jounih/dc-cv-interface/variants/pico2-4x4/hw/netlist.csv

ref | value | footprint | pin | net
J1 | Eurorack 2x5 shrouded header | IDC 2x5 2.54 mm | 1 | -12V_IN
J1 | Eurorack 2x5 shrouded header | IDC 2x5 2.54 mm | 2 | -12V_IN
J1 | Eurorack 2x5 shrouded header | IDC 2x5 2.54 mm | 3 | GND
J1 | Eurorack 2x5 shrouded header | IDC 2x5 2.54 mm | 4 | GND
J1 | Eurorack 2x5 shrouded header | IDC 2x5 2.54 mm | 5 | GND
J1 | Eurorack 2x5 shrouded header | IDC 2x5 2.54 mm | 6 | GND
J1 | Eurorack 2x5 shrouded header | IDC 2x5 2.54 mm | 7 | GND
J1 | Eurorack 2x5 shrouded header | IDC 2x5 2.54 mm | 8 | GND
J1 | Eurorack 2x5 shrouded header | IDC 2x5 2.54 mm | 9 | +12V_IN
J1 | Eurorack 2x5 shrouded header | IDC 2x5 2.54 mm | 10 | +12V_IN
D1 | SS14 | SMA / DO-214AC | A | +12V_IN
D1 | SS14 | SMA / DO-214AC | K | +12V
D2 | SS14 | SMA / DO-214AC | A | -12V
D2 | SS14 | SMA / DO-214AC | K | -12V_IN
C1 | 10uF 25V | 0805 X5R / radial | 1 | +12V
C1 | 10uF 25V | 0805 X5R / radial | 2 | GND
C2 | 10uF 25V | 0805 X5R / radial | 1 | GND
C2 | 10uF 25V | 0805 X5R / radial | 2 | -12V
U1 | Raspberry Pi Pico 2 (RP2350) | Pico module | 4 | DAC_SCLK
U1 | Raspberry Pi Pico 2 (RP2350) | Pico module | 5 | DAC_SYNC
U1 | Raspberry Pi Pico 2 (RP2350) | Pico module | 6 | DAC_DIN
U1 | Raspberry Pi Pico 2 (RP2350) | Pico module | 14 | ADC_SCLK
U1 | Raspberry Pi Pico 2 (RP2350) | Pico module | 15 | ADC_CS
U1 | Raspberry Pi Pico 2 (RP2350) | Pico module | 16 | ADC_DOUT
U1 | Raspberry Pi Pico 2 (RP2350) | Pico module | 17 | ADC_DRDY
U1 | Raspberry Pi Pico 2 (RP2350) | Pico module | 19 | ADC_DIN
U1 | Raspberry Pi Pico 2 (RP2350) | Pico module | 20 | ADC_RESET
U1 | Raspberry Pi Pico 2 (RP2350) | Pico module | 27 | ADC_CLKIN
U1 | Raspberry Pi Pico 2 (RP2350) | Pico module | 36 | +3V3_D
U1 | Raspberry Pi Pico 2 (RP2350) | Pico module | 40 | VBUS
U1 | Raspberry Pi Pico 2 (RP2350) | Pico module | 3 | GND
U1 | Raspberry Pi Pico 2 (RP2350) | Pico module | 8 | GND
U1 | Raspberry Pi Pico 2 (RP2350) | Pico module | 13 | GND
U1 | Raspberry Pi Pico 2 (RP2350) | Pico module | 18 | GND
U1 | Raspberry Pi Pico 2 (RP2350) | Pico module | 23 | GND
U1 | Raspberry Pi Pico 2 (RP2350) | Pico module | 28 | GND
U1 | Raspberry Pi Pico 2 (RP2350) | Pico module | 33 | GND
U1 | Raspberry Pi Pico 2 (RP2350) | Pico module | 38 | GND
U5 | MCP1700-3302E (LDO 3.3 V) | TO-92 (breadboard) / SOT-23 | IN | VBUS
U5 | MCP1700-3302E (LDO 3.3 V) | TO-92 (breadboard) / SOT-23 | GND | GND
U5 | MCP1700-3302E (LDO 3.3 V) | TO-92 (breadboard) / SOT-23 | OUT | +3V3_A
C3 | 1uF | 0805 | 1 | VBUS
C3 | 1uF | 0805 | 2 | GND
C4 | 1uF | 0805 | 1 | +3V3_A
C4 | 1uF | 0805 | 2 | GND
U2 | DAC8568BIPW | TSSOP-16 | 1 | +3V3_A
U2 | DAC8568BIPW | TSSOP-16 | 2 | DAC_SYNC
U2 | DAC8568BIPW | TSSOP-16 | 3 | +3V3_A
U2 | DAC8568BIPW | TSSOP-16 | 4 | DAC_OUT1
U2 | DAC8568BIPW | TSSOP-16 | 5 | DAC_OUT3
U2 | DAC8568BIPW | TSSOP-16 | 6 | DAC_OUT5
U2 | DAC8568BIPW | TSSOP-16 | 7 | DAC_OUT7
U2 | DAC8568BIPW | TSSOP-16 | 8 | VREF
U2 | DAC8568BIPW | TSSOP-16 | 9 | +3V3_A
U2 | DAC8568BIPW | TSSOP-16 | 10 | DAC_OUT8
U2 | DAC8568BIPW | TSSOP-16 | 11 | DAC_OUT6
U2 | DAC8568BIPW | TSSOP-16 | 12 | DAC_OUT4
U2 | DAC8568BIPW | TSSOP-16 | 13 | DAC_OUT2
U2 | DAC8568BIPW | TSSOP-16 | 14 | GND
U2 | DAC8568BIPW | TSSOP-16 | 15 | DAC_DIN
U2 | DAC8568BIPW | TSSOP-16 | 16 | DAC_SCLK
C5 | 100nF | 0805 | 1 | +3V3_A
C5 | 100nF | 0805 | 2 | GND
C6 | 1uF | 0805 | 1 | +3V3_A
C6 | 1uF | 0805 | 2 | GND
C7 | 150nF C0G/X7R | 0805 | 1 | VREF
C7 | 150nF C0G/X7R | 0805 | 2 | GND
R1 | 10k | 0805 | 1 | DAC_SYNC
R1 | 10k | 0805 | 2 | +3V3_D
R2 | 10k 0.1% | 0805 | 1 | VREF
R2 | 10k 0.1% | 0805 | 2 | VB
R3 | 8.06k 0.1% | 0805 | 1 | VB
R3 | 8.06k 0.1% | 0805 | 2 | GND
C8 | 100pF C0G | 0805 | 1 | VB
C8 | 100pF C0G | 0805 | 2 | GND
U4 | OPA4172ID | SOIC-14 | 4 | +12V
U4 | OPA4172ID | SOIC-14 | 11 | -12V
U4 | OPA4172ID | SOIC-14 | 1 | OPO1
U4 | OPA4172ID | SOIC-14 | 2 | SUM1
U4 | OPA4172ID | SOIC-14 | 3 | VB
U4 | OPA4172ID | SOIC-14 | 7 | OPO2
U4 | OPA4172ID | SOIC-14 | 6 | SUM2
U4 | OPA4172ID | SOIC-14 | 5 | VB
U4 | OPA4172ID | SOIC-14 | 8 | OPO3
U4 | OPA4172ID | SOIC-14 | 9 | SUM3
U4 | OPA4172ID | SOIC-14 | 10 | VB
U4 | OPA4172ID | SOIC-14 | 14 | OPO4
U4 | OPA4172ID | SOIC-14 | 13 | SUM4
U4 | OPA4172ID | SOIC-14 | 12 | VB
C9 | 100nF | 0805 | 1 | +12V
C9 | 100nF | 0805 | 2 | GND
C10 | 100nF | 0805 | 1 | GND
C10 | 100nF | 0805 | 2 | -12V
R11 | 10k 0.1% | 0805 | 1 | DAC_OUT1
R11 | 10k 0.1% | 0805 | 2 | SUM1
RF1 | 82.5k 0.1% | 0805 | 1 | SUM1
RF1 | 82.5k 0.1% | 0805 | 2 | OPO1
CF1 | 47pF C0G | 0805 | 1 | SUM1
CF1 | 47pF C0G | 0805 | 2 | OPO1
DC1 | BAT54S | SOT-23 | 1 | -12V
DC1 | BAT54S | SOT-23 | 2 | +12V
DC1 | BAT54S | SOT-23 | 3 | OPO1
RS1 | 1k 0.66 W anti-surge | 1206 | 1 | OPO1
RS1 | 1k 0.66 W anti-surge | 1206 | 2 | OUT1
JO1 | Thonkiconn PJ398SM | 3.5 mm jack | T | OUT1
JO1 | Thonkiconn PJ398SM | 3.5 mm jack | S | GND
JO1 | Thonkiconn PJ398SM | 3.5 mm jack | TN | NC
R12 | 10k 0.1% | 0805 | 1 | DAC_OUT2
R12 | 10k 0.1% | 0805 | 2 | SUM2
RF2 | 82.5k 0.1% | 0805 | 1 | SUM2
RF2 | 82.5k 0.1% | 0805 | 2 | OPO2
CF2 | 47pF C0G | 0805 | 1 | SUM2
CF2 | 47pF C0G | 0805 | 2 | OPO2
DC2 | BAT54S | SOT-23 | 1 | -12V
DC2 | BAT54S | SOT-23 | 2 | +12V
DC2 | BAT54S | SOT-23 | 3 | OPO2
RS2 | 1k 0.66 W anti-surge | 1206 | 1 | OPO2
RS2 | 1k 0.66 W anti-surge | 1206 | 2 | OUT2
JO2 | Thonkiconn PJ398SM | 3.5 mm jack | T | OUT2
JO2 | Thonkiconn PJ398SM | 3.5 mm jack | S | GND
JO2 | Thonkiconn PJ398SM | 3.5 mm jack | TN | NC
R13 | 10k 0.1% | 0805 | 1 | DAC_OUT3
R13 | 10k 0.1% | 0805 | 2 | SUM3
RF3 | 82.5k 0.1% | 0805 | 1 | SUM3
RF3 | 82.5k 0.1% | 0805 | 2 | OPO3
CF3 | 47pF C0G | 0805 | 1 | SUM3
CF3 | 47pF C0G | 0805 | 2 | OPO3
DC3 | BAT54S | SOT-23 | 1 | -12V
DC3 | BAT54S | SOT-23 | 2 | +12V
DC3 | BAT54S | SOT-23 | 3 | OPO3
RS3 | 1k 0.66 W anti-surge | 1206 | 1 | OPO3
RS3 | 1k 0.66 W anti-surge | 1206 | 2 | OUT3
JO3 | Thonkiconn PJ398SM | 3.5 mm jack | T | OUT3
JO3 | Thonkiconn PJ398SM | 3.5 mm jack | S | GND
JO3 | Thonkiconn PJ398SM | 3.5 mm jack | TN | NC
R14 | 10k 0.1% | 0805 | 1 | DAC_OUT4
R14 | 10k 0.1% | 0805 | 2 | SUM4
RF4 | 82.5k 0.1% | 0805 | 1 | SUM4
RF4 | 82.5k 0.1% | 0805 | 2 | OPO4
CF4 | 47pF C0G | 0805 | 1 | SUM4
CF4 | 47pF C0G | 0805 | 2 | OPO4
DC4 | BAT54S | SOT-23 | 1 | -12V
DC4 | BAT54S | SOT-23 | 2 | +12V
DC4 | BAT54S | SOT-23 | 3 | OPO4
RS4 | 1k 0.66 W anti-surge | 1206 | 1 | OPO4
RS4 | 1k 0.66 W anti-surge | 1206 | 2 | OUT4
JO4 | Thonkiconn PJ398SM | 3.5 mm jack | T | OUT4
JO4 | Thonkiconn PJ398SM | 3.5 mm jack | S | GND
JO4 | Thonkiconn PJ398SM | 3.5 mm jack | TN | NC
U3 | ADS131M04IPW | TSSOP-20 | 1 | +3V3_A
U3 | ADS131M04IPW | TSSOP-20 | 2 | GND
U3 | ADS131M04IPW | TSSOP-20 | 3 | AIN1
U3 | ADS131M04IPW | TSSOP-20 | 4 | GND
U3 | ADS131M04IPW | TSSOP-20 | 5 | GND
U3 | ADS131M04IPW | TSSOP-20 | 6 | AIN2
U3 | ADS131M04IPW | TSSOP-20 | 7 | AIN3
U3 | ADS131M04IPW | TSSOP-20 | 8 | GND
U3 | ADS131M04IPW | TSSOP-20 | 9 | GND
U3 | ADS131M04IPW | TSSOP-20 | 10 | AIN4
U3 | ADS131M04IPW | TSSOP-20 | 11 | ADC_RESET
U3 | ADS131M04IPW | TSSOP-20 | 12 | ADC_CS
U3 | ADS131M04IPW | TSSOP-20 | 13 | ADC_DRDY
U3 | ADS131M04IPW | TSSOP-20 | 14 | ADC_SCLK
U3 | ADS131M04IPW | TSSOP-20 | 15 | ADC_DOUT
U3 | ADS131M04IPW | TSSOP-20 | 16 | ADC_DIN
U3 | ADS131M04IPW | TSSOP-20 | 17 | ADC_CLKIN
U3 | ADS131M04IPW | TSSOP-20 | 18 | ADC_CAP
U3 | ADS131M04IPW | TSSOP-20 | 19 | GND
U3 | ADS131M04IPW | TSSOP-20 | 20 | +3V3_D
C11 | 1uF | 0805 | 1 | +3V3_A
C11 | 1uF | 0805 | 2 | GND
C12 | 1uF | 0805 | 1 | +3V3_D
C12 | 1uF | 0805 | 2 | GND
C13 | 220nF | 0805 | 1 | ADC_CAP
C13 | 220nF | 0805 | 2 | GND
R4 | 10k | 0805 | 1 | ADC_CS
R4 | 10k | 0805 | 2 | +3V3_D
JI1 | Thonkiconn PJ398SM | 3.5 mm jack | T | IN1
JI1 | Thonkiconn PJ398SM | 3.5 mm jack | S | GND
JI1 | Thonkiconn PJ398SM | 3.5 mm jack | TN | GND
RA1 | 49.9k 1% | 0805 | 1 | IN1
RA1 | 49.9k 1% | 0805 | 2 | INM1
RB1 | 49.9k 1% | 0805 | 1 | INM1
RB1 | 49.9k 1% | 0805 | 2 | AIN1
RC1 | 9.09k 1% | 0805 | 1 | AIN1
RC1 | 9.09k 1% | 0805 | 2 | GND
CA1 | 330pF C0G | 0805 | 1 | AIN1
CA1 | 330pF C0G | 0805 | 2 | GND
JI2 | Thonkiconn PJ398SM | 3.5 mm jack | T | IN2
JI2 | Thonkiconn PJ398SM | 3.5 mm jack | S | GND
JI2 | Thonkiconn PJ398SM | 3.5 mm jack | TN | GND
RA2 | 49.9k 1% | 0805 | 1 | IN2
RA2 | 49.9k 1% | 0805 | 2 | INM2
RB2 | 49.9k 1% | 0805 | 1 | INM2
RB2 | 49.9k 1% | 0805 | 2 | AIN2
RC2 | 9.09k 1% | 0805 | 1 | AIN2
RC2 | 9.09k 1% | 0805 | 2 | GND
CA2 | 330pF C0G | 0805 | 1 | AIN2
CA2 | 330pF C0G | 0805 | 2 | GND
JI3 | Thonkiconn PJ398SM | 3.5 mm jack | T | IN3
JI3 | Thonkiconn PJ398SM | 3.5 mm jack | S | GND
JI3 | Thonkiconn PJ398SM | 3.5 mm jack | TN | GND
RA3 | 49.9k 1% | 0805 | 1 | IN3
RA3 | 49.9k 1% | 0805 | 2 | INM3
RB3 | 49.9k 1% | 0805 | 1 | INM3
RB3 | 49.9k 1% | 0805 | 2 | AIN3
RC3 | 9.09k 1% | 0805 | 1 | AIN3
RC3 | 9.09k 1% | 0805 | 2 | GND
CA3 | 330pF C0G | 0805 | 1 | AIN3
CA3 | 330pF C0G | 0805 | 2 | GND
JI4 | Thonkiconn PJ398SM | 3.5 mm jack | T | IN4
JI4 | Thonkiconn PJ398SM | 3.5 mm jack | S | GND
JI4 | Thonkiconn PJ398SM | 3.5 mm jack | TN | GND
RA4 | 49.9k 1% | 0805 | 1 | IN4
RA4 | 49.9k 1% | 0805 | 2 | INM4
RB4 | 49.9k 1% | 0805 | 1 | INM4
RB4 | 49.9k 1% | 0805 | 2 | AIN4
RC4 | 9.09k 1% | 0805 | 1 | AIN4
RC4 | 9.09k 1% | 0805 | 2 | GND
CA4 | 330pF C0G | 0805 | 1 | AIN4
CA4 | 330pF C0G | 0805 | 2 | GND
