jounih/dc-cv-interface/hw/results/spice_summary.md

# SPICE summary (generated by hw/spice/run_spice.py)

- [x] output reaches beyond +-10 V into 100 k
- [x] sim matches firmware cal model within 5 mV
- [x] hard +-15 V fault: series R < 0.66 W (ERJ-P08 1206)
- [x] hard +-15 V fault: op-amp current < 40 mA
- [x] rails-off fault: Schottky clamp carries > 80 % of the fault current
- [x] ref turn-on transient < 200 mV with CB = 100 pF (50 us ref ramp)
- [x] input impedance ~100 k
- [x] ADC pin inside abs max (-1.6 V) at -15 V
- [x] ADC ESD current < 1 mA at +-24 V
- [x] reversed rail header blocks (< 10 uA)
- [x] codec out: +-full scale reaches beyond +-10 V
- [x] codec out: 0 V when the codec is unpowered or at VCOM
- [x] codec out: DAC pin load >= 15 k (datasheet DC-coupled minimum)
- [x] codec in: pin stays within 0..4.5 V for +-24 V at the jack
- [x] codec in: 0 V maps to VCOM within 10 mV
- [x] codec in: +-10 V inside the ADC full scale (VCOM +-1.27 V)
- [x] DC-DC ripple at the jack < 50 uVpp (estimate)
- [x] tier A in: ADS1115 pin inside -0.3..3.6 V (abs max) for +-15 V

```json
{
 "out_dc": {
  "jack_at_code0_V": 10.2182,
  "jack_at_code61440_V": -8.92613,
  "volts_per_code": -0.00031159376051958875,
  "zero_code_sim": 32793.29462461873,
  "zero_code_model": 32793,
  "max_nonlinearity_mV": 0.014008088234263028,
  "max_dev_from_firmware_model_mV": 0.08730611931717647
 },
 "out_faults": {
  "hard_+15V_while_-10V": {
   "opamp_out_current_mA": -24.3621,
   "series_R_current_mA": -24.3621,
   "series_R_power_W": 0.5935119164100001,
   "clamp_diode_current_mA": 0.0,
   "opamp_out_V": -9.36206
  },
  "hard_-15V_while_+10V": {
   "opamp_out_current_mA": 24.3635,
   "series_R_current_mA": 24.3635,
   "series_R_power_W": 0.5935801322500001,
   "clamp_diode_current_mA": 0.0,
   "opamp_out_V": 9.36355
  },
  "module_+12V_1k_while_-10V": {
   "opamp_out_current_mA": -11.0427,
   "series_R_current_mA": -11.0427,
   "series_R_power_W": 0.12194122329000003,
   "clamp_diode_current_mA": 0.0,
   "opamp_out_V": -10.0855
  },
  "hard_+15V_rails_off": {
   "opamp_out_current_mA": 0.00992839,
   "series_R_current_mA": -14.6678,
   "series_R_power_W": 0.21514435684,
   "clamp_diode_current_mA": 14.67772839,
   "opamp_out_V": 0.332192
  },
  "hard_-15V_rails_off": {
   "opamp_out_current_mA": 0.0171181,
   "series_R_current_mA": 14.6679,
   "series_R_power_W": 0.21514729040999997,
   "clamp_diode_current_mA": -14.6507819,
   "opamp_out_V": -0.332086
  }
 },
 "out_noise": {
  "at_0V_uVrms": 104.39099999999999,
  "at_+10V_uVrms": 102.622,
  "note": "assumes 90 nV/rtHz DAC output noise and 50 nV/rtHz reference noise; 1 cent at 1 V/oct = 833 uV"
 },
 "out_ac": {
  "f_minus3dB_kHz": 39.6974
 },
 "out_ref_turn_on": {
  "CB_10nF_peak_mV": 5849.8099999999995,
  "CB_0.1nF_peak_mV": 5.4874600000000004
 },
 "in_dc": {
  "-24V": {
   "adc_pin_V": -1.57623,
   "input_current_uA": -224.687,
   "esd_current_uA": -46.50790519051904
  },
  "-15V": {
   "adc_pin_V": -1.22135,
   "input_current_uA": -138.06300000000002,
   "esd_current_uA": -3.200320062160067e-06
  },
  "-12V": {
   "adc_pin_V": -0.977078,
   "input_current_uA": -110.45,
   "esd_current_uA": 0.00017135713571604587
  },
  "-10V": {
   "adc_pin_V": -0.814231,
   "input_current_uA": -92.0418,
   "esd_current_uA": -6.589658965368994e-05
  },
  "+0V": {
   "adc_pin_V": 1.86899e-08,
   "input_current_uA": -1.87273e-07,
   "esd_current_uA": -2.3000036700670066e-06
  },
  "+10V": {
   "adc_pin_V": 0.814231,
   "input_current_uA": 92.0418,
   "esd_current_uA": 6.589658965368994e-05
  },
  "+12V": {
   "adc_pin_V": 0.977078,
   "input_current_uA": 110.45,
   "esd_current_uA": -0.00017135713571604587
  },
  "+15V": {
   "adc_pin_V": 1.22135,
   "input_current_uA": 138.06300000000002,
   "esd_current_uA": 3.200320062160067e-06
  },
  "+24V": {
   "adc_pin_V": 1.95416,
   "input_current_uA": 220.9,
   "esd_current_uA": -0.0007948794879348241
  }
 },
 "in_summary": {
  "input_impedance_kOhm": 108.6462889687077,
  "adc_full_scale_at_jack_V": 14.73783238417599,
  "within_recommended_-1.3V_at_-15V": true
 },
 "in_ac_noise": {
  "f_minus3dB_kHz": 59.3589,
  "divider_noise_referred_to_jack_uVrms": 19.786890943724817,
  "adc_noise_referred_to_jack_uVrms_full_band": 925.2902431865158,
  "total_referred_to_jack_uVrms": 925.5017856219297,
  "note": "ADC noise at OSR 64 is shaped toward Nyquist; a 1 kHz software low-pass cuts it several-fold"
 },
 "power": {
  "forward_rail_V_at_40mA": 11.7279,
  "reversed_header_current_uA": 3.00001
 },
 "codec_out": {
  "jack_at_+FS_V": 10.2459,
  "jack_at_-FS_V": -10.2459,
  "jack_at_zero_V": 3.89756e-09,
  "jack_codec_unpowered_V": 1.5037e-27,
  "codec_pin_load_kOhm": 111.19988797640914
 },
 "codec_in": {
  "-24V": {
   "codec_pin_V": 4.13106,
   "input_current_uA": -253.477
  },
  "-15V": {
   "codec_pin_V": 3.89683,
   "input_current_uA": -170.275
  },
  "-10V": {
   "codec_pin_V": 3.34805,
   "input_current_uA": -120.27499999999999
  },
  "+0V": {
   "codec_pin_V": 2.25049,
   "input_current_uA": -20.2747
  },
  "+10V": {
   "codec_pin_V": 1.15293,
   "input_current_uA": 79.72529999999999
  },
  "+15V": {
   "codec_pin_V": 0.604151,
   "input_current_uA": 129.725
  },
  "+24V": {
   "codec_pin_V": 0.366921,
   "input_current_uA": 212.95499999999998
  }
 },
 "dcdc_ripple": {
  "module_ripple_mVpp": 100.0,
  "after_pi_filter_mVpp": 0.0834299,
  "rail_after_ldo_uVpp": 0.46916080526498305,
  "estimated_at_jack_uVpp": 0.004339737448701093,
  "assumptions": "100 kHz, LDO PSRR 45.0 dB, op-amp PSRR 60.0 dB"
 },
 "tier_a": {
  "out_jack_V (TL074 swing 10.5 V on +-12 V)": {
   "dac_0.0V": 10.0362,
   "dac_2.048V": -0.00177757,
   "dac_4.095V": -10.0328
  },
  "in_adc_pin_V": {
   "-24V": -0.891892,
   "-15V": -1.08293e-16,
   "-10V": 0.495495,
   "+10V": 2.47748,
   "+15V": 2.97297,
   "+24V": 3.86486
  }
 }
}
```
