jounih/dc-cv-interface/hw/spice/out_fault_hard_m15v_rails_off.cir

* hard_-15V_rails_off
.include models.lib
.param VREFV=2.5 CBV=1e-08
Vcc vcc 0 0.0
Vee vee 0 -0.0
Vcode code 0 DC 32793 AC 1

Bref vref 0 V={VREFV}+V(rn)
Rrn rn 0 150820
Bdac dac 0 V=V(vref)*V(code)/65536+V(dn)
Rdn dn 0 488656
RT vref vb 10000
RB vb 0 8060
CB vb 0 {CBV}
R1 dac inn 10000
RF inn opo 82500
CF inn opo 4.7e-11
XU vb inn opo vcc vee OPA
Vmeas opo opo2 0
Dp opo2 vcc BAT54
Dn vee opo2 BAT54
RS opo2 jack 1000

Vf jack 0 -15
.control
op
let iop = i(vmeas)
echo RES i_opamp = $&iop
let irs = (v(opo2)-v(jack))/1000
echo RES i_rs = $&irs
let vop = v(opo)
echo RES v_opamp = $&vop
let ivcc = i(vcc)
echo RES i_vcc = $&ivcc
let ivee = i(vee)
echo RES i_vee = $&ivee

.endc
.end
