jounih/dc-cv-interface/(commit log)

2026-10-08 CV interface: UAC2 DC-coupled 4x4 USB interface for Circuit Studio (Pico 2 + DAC8568 + ADS131M04): firmware, host tests, SPICE checks, netlist/BOM/schematic, breadboard guide
    [bom.csv, netlist.csv]
2026-10-08 SPICE: keep fault-case netlist names distinct; untrack test binaries
2026-10-08 v2: ESP32-S3 (T-Display-S3) controller, PCM3168A audio-rate group over UAC2 at 32 kHz (USB FS budget), DAC8568/ADS131M08 precision CV over Web MIDI SysEx, BLE-MIDI and MIDI->CV mapper, display, USB-C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
    [bom.csv, bom_audio.csv, bom_full.csv, bom_precision.csv, netlist.csv]
2026-10-08 Keep the Pico 2 4-in/4-out design as a budget variant (variants/pico2-4x4: README, BOM, netlist, schematic, SPICE, firmware)
    [bom.csv, netlist.csv]
